Stellamove/Documents/README.md

# Documents
3D Part STL files and Documents related to Pitta
