Stellamove/Documents/3D Models/Spool/Spool_Cover.stl

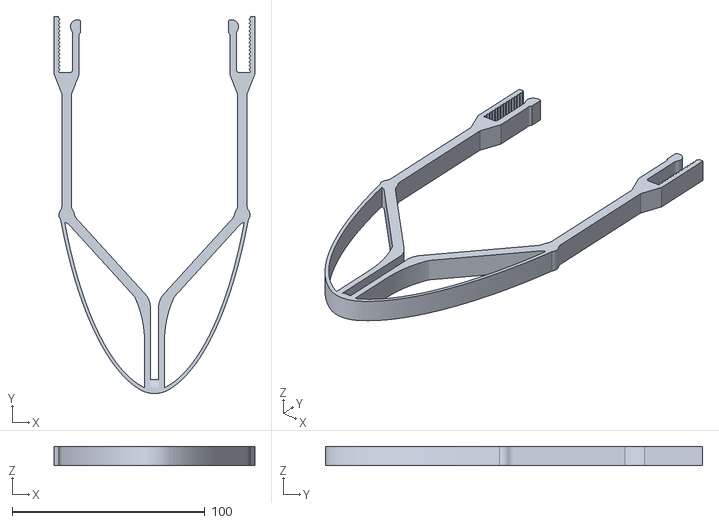
[picture p1: CAD file, 2022-07-28]
3D Models/Spool/Spool_Cover.stl
104.0 x 195.4 x 10.0
