Stellamove/Documents/3D Models/Spool/Spool_Bar_cover#2.stl

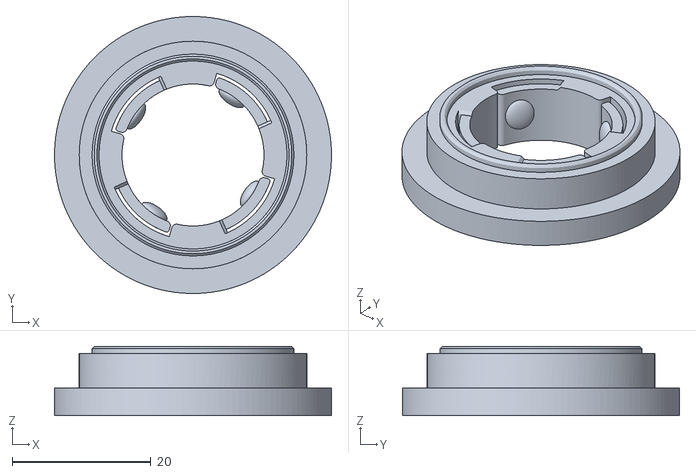
[picture p2: CAD file, 2022-07-28]
3D Models/Spool/Spool_Bar_cover#2.stl
40.0 x 40.0 x 10.0
