Stellamove/Documents/3D Models/Spool/Spool_Bar.stl

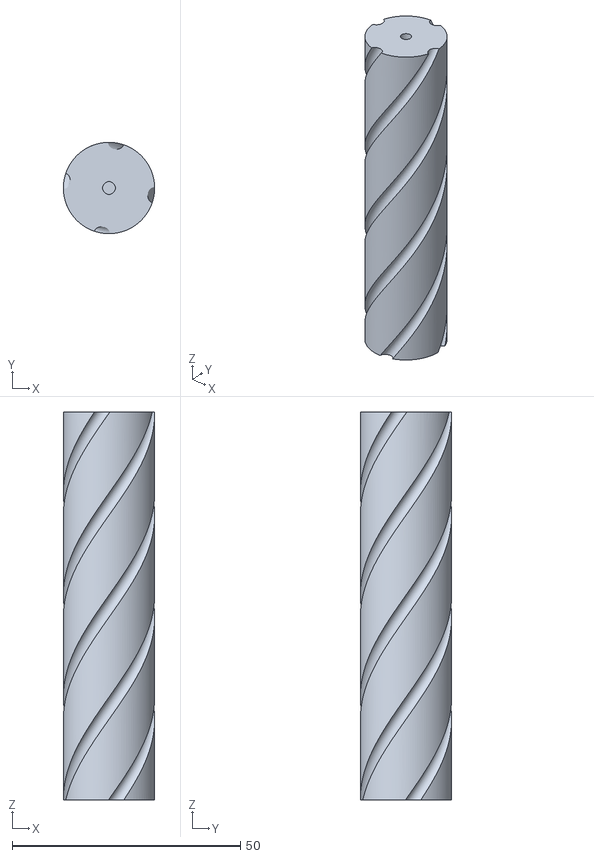
[picture p3: CAD file, 2022-07-28]
3D Models/Spool/Spool_Bar.stl
20.0 x 20.0 x 85.0
