Stellamove/Documents/3D Models/Spool/Spool_Tube Holder.stl

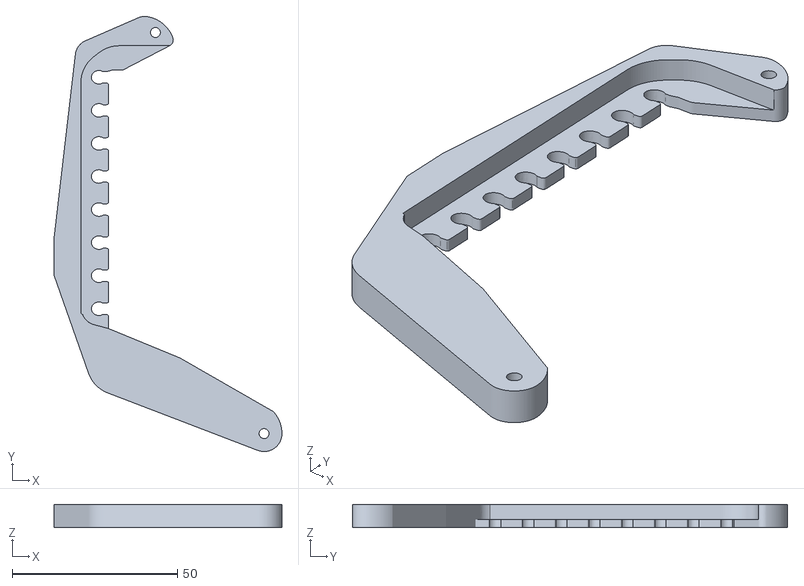
[picture p4: CAD file, 2022-07-28]
3D Models/Spool/Spool_Tube Holder.stl
68.9 x 131.6 x 7.00
