Stellamove/Documents/3D Models/Spool/Spool_Bar_cover#1.stl

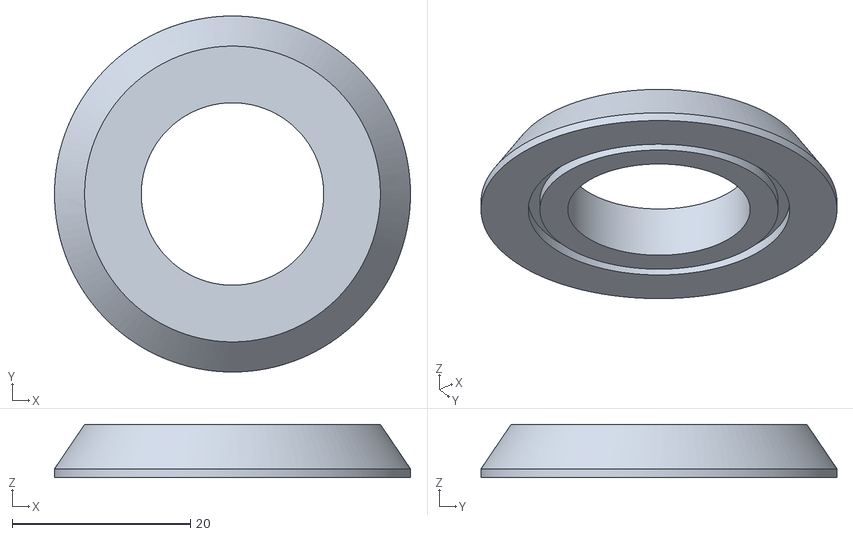
[picture p5: CAD file, 2022-07-28]
3D Models/Spool/Spool_Bar_cover#1.stl
40.0 x 40.0 x 6.00
