Stellamove/Documents/3D Models/Spool/Spool_Body.stl

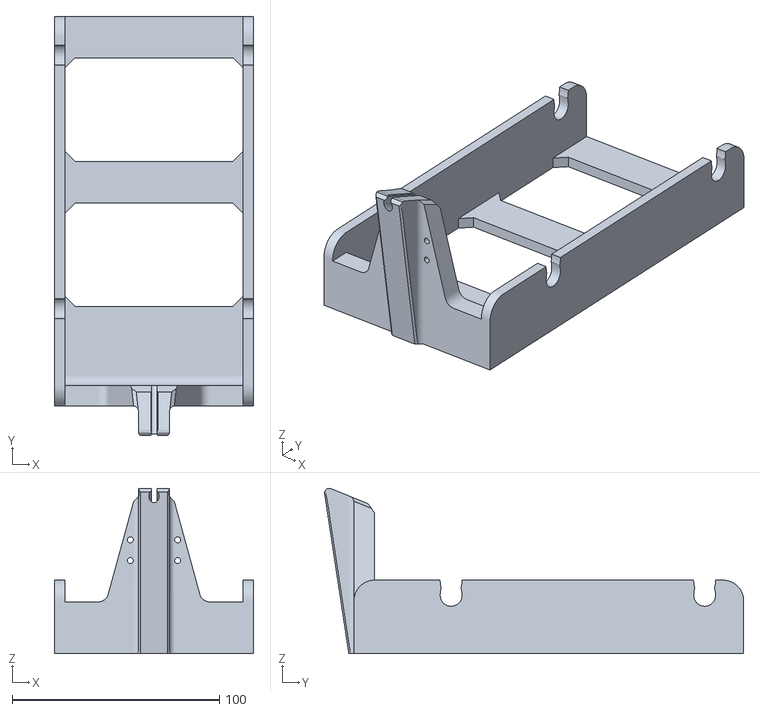
[picture p6: CAD file, 2022-07-08]
3D Models/Spool/Spool_Body.stl
96.0 x 202.3 x 79.8
