Stellamove/Documents/Manual/PITTA-User-Manual.pdf

# Multi-Color 3D Printing Module

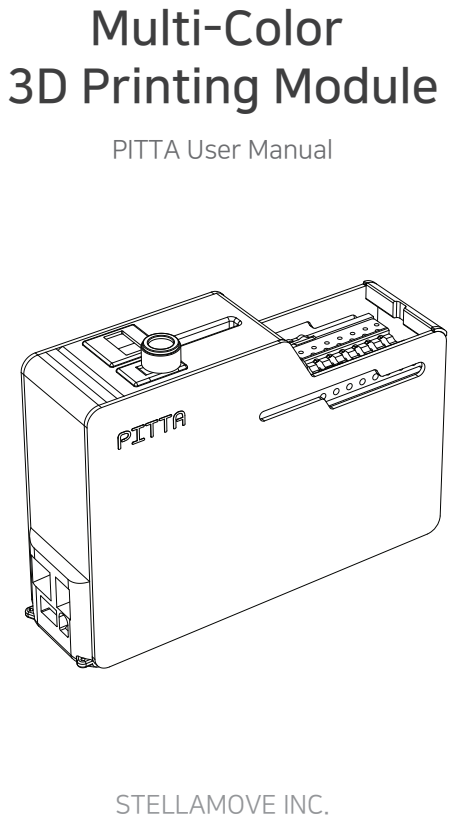
[picture p25: page 1]
STELLAMOVE INC.

PITTA User Manual

NOTES

UNPACKING

PARTS & FUNCTIONS

INSTALLATION & PREPARATION

02

03

04

06

HARD GRIP TUNING

Firmware Download for 3D Printer

PITTA MENU

Install EXTRUDER COMBINER

Install CYLINDER NOZZLE ASSEMBLY

Install PITTA BASE and BOWDEN TUBE

Install MOTOR EXTENSION CABLE

Install COMM EXTENSION CABLE

Friction Handling

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
# Contents

In the user manual, some functions may be changed without prior notice to the user to improve product performance. Please read [NOTES] before use.

8. TROUBLESHOOTING | 19
9. SPLITTER BOBBIN USAGE | 20

MENU & FUNCTIONS

TB_LEN : Length of detector to nozzle tube

BR_POS : Offset value of the Bearing Position

16

17

18

The PITTA is a precision machine and must be handled with care.

Check that the PITTA and 3D Printer are properly connected with various cables. (6~10page)

Turn on the power of the PITTA using the power switch. (Be sure to turn off the power when not in use)

Make sure all materials to be used are loaded in the proper location.

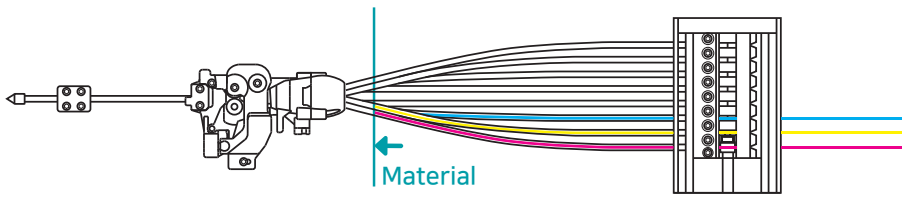
[picture p26: figure]
Material

Check that the drive gear of the PITTA and the Splitter Bobbin Usage is not loose.

Check that PITTA's drive gear is positioned to be in slot 1.

Before starting printing, use the PreHeat function to check whether the nozzle temperature is set to rise. 3D Printer will not start 3D Printing unless the nozzle temperature is at least 185 degrees.

Make sure the drive gear positions of the hard grip and PITTA are tuned for maximum extrusion pressure. (11~12,18page)

Recommendation : Material PLA, Nozzle Temp 205~215, Bed Temp 50 ~ 60°C

During PITTA working, ender3 UI blocked, so stop, pause etc will not work. It is because the ender's UI and its interaction with PITTA during PITTA operation interfere with the system operation.

Please use it on a flat floor out of direct sunlight.
If left unused for a long time, it may cause malfunction.
When storing, avoid direct sunlight and heat, and be careful not to accumulate dust. Do not disassemble the machine arbitrarily.

Always tidy up and clean after finishing work. (Foreign substances such as strings may cause clogging of the nozzle or machine failure)

The ideal ambient operating temperature is from 15 - 30 °C (60 - 86 °F).

# NOTES

# Quick Check Points Before start printing

# UNPACKING

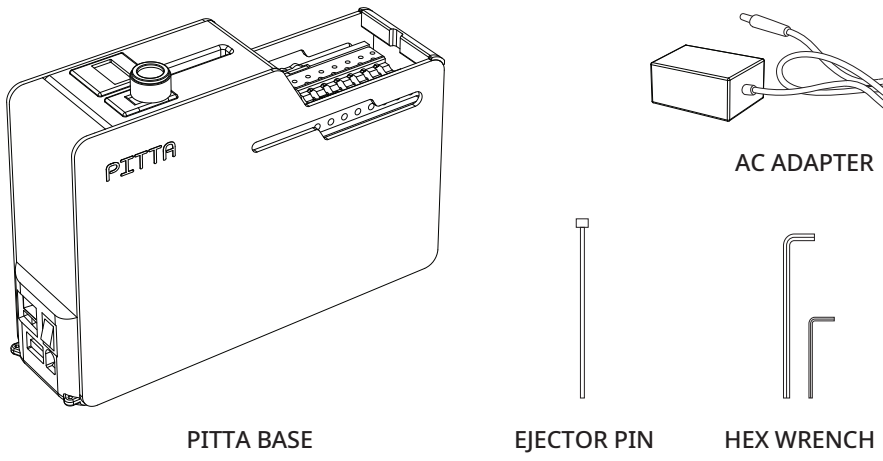
[picture p27: figure]
PITTA BASE; EJECTOR PIN; HEX WRENCH; AC ADAPTER

DETECTOR CABLE

MOTOR EXTENSION CABLE | COMM EXTENSION CABLE

PITTA LOGO STIKER

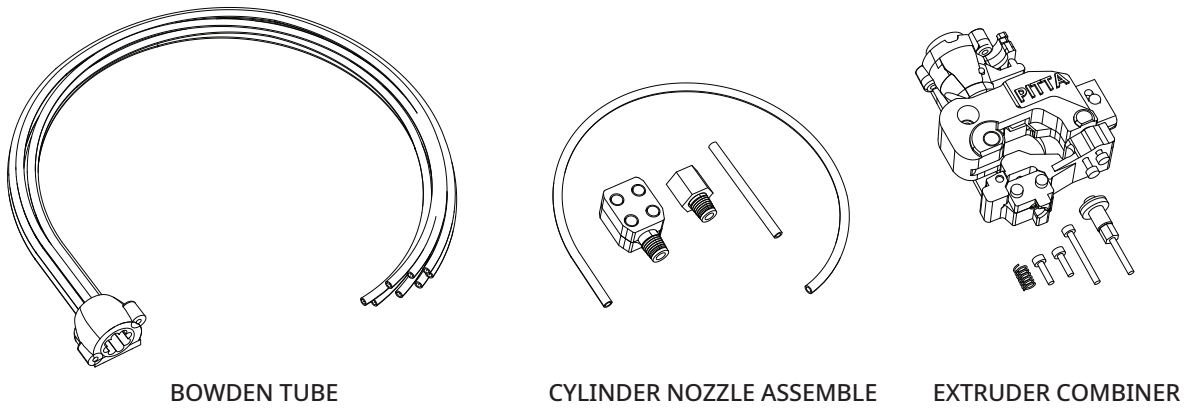
[picture p28: figure]
BOWDEN TUBE; CYLINDER NOZZLE ASSEMBLE; EXTRUDER COMBINER

The illustrations may differ slightly from the items shipped with your product.
PITTA is not responsible for any problems caused by using unauthorized accessories. Documentation and other materials necessary for installation and use can be obtained from the blog. (https://pitta-color-3dprinting.blogspot.com)

## PITTA BASE

ADAPTATION KIT (For Ender3 V2 or Pro 32bit)

# PARTS & FUNCTIONS

## PITTA BASE

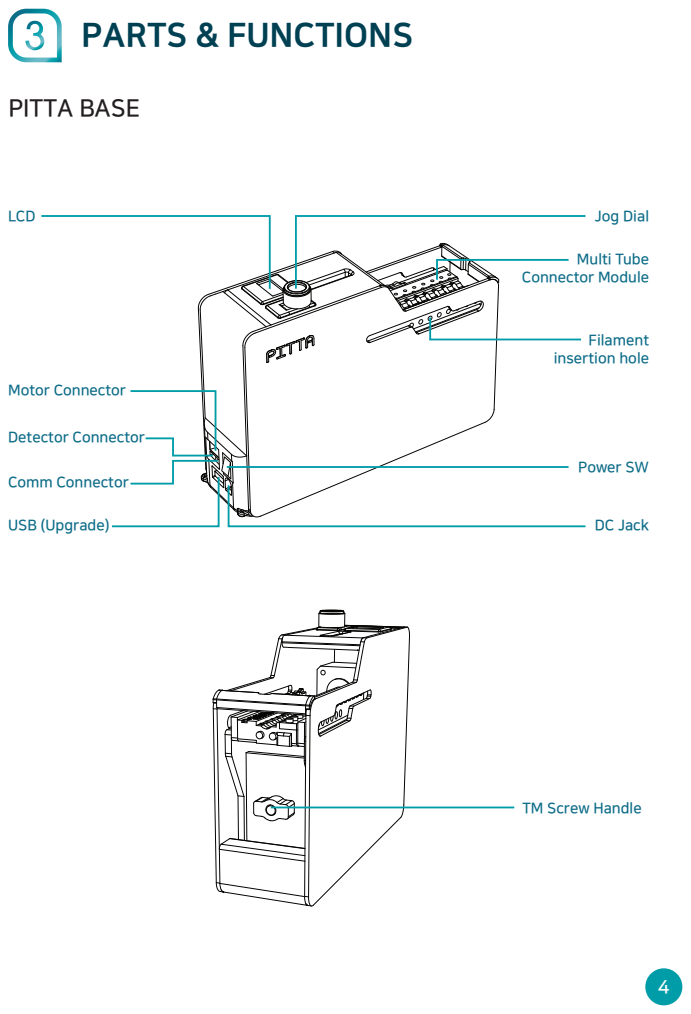
[picture p29: page 5]
LCD; Comm Connector; Detector Connector; Motor Connector; USB (Upgrade); Jog Dial; Multi Tube Connector Module; Filament insertion hole; DC Jack; Power SW

TM Screw Handle

## EXTRUDER COMBINER

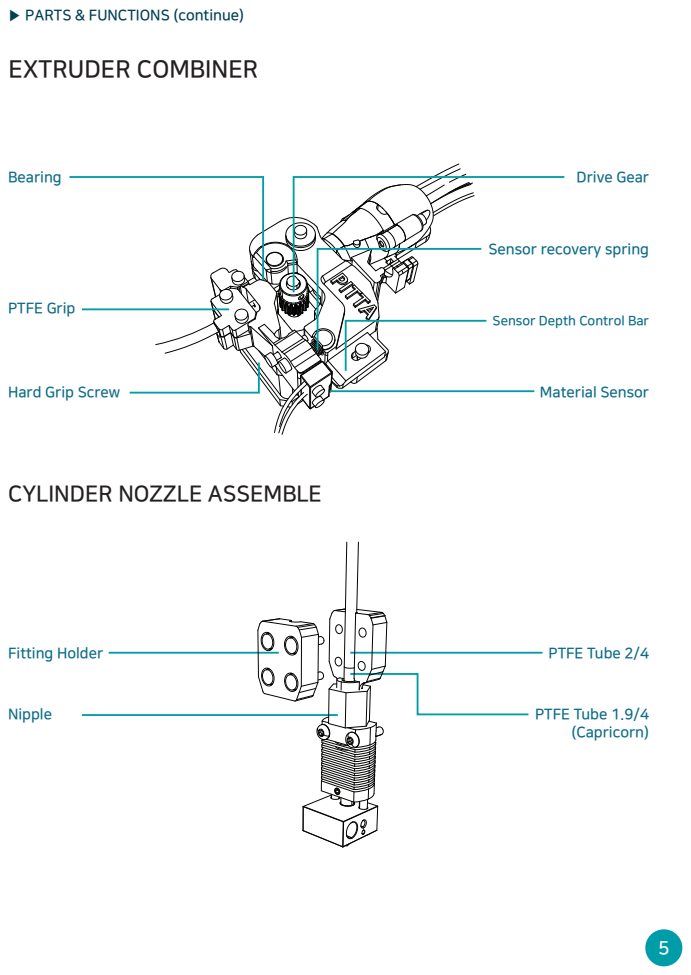
[picture p30: page 6]
Bearing; PTFE Grip; Drive Gear; Material Sensor; Fitting Holder; Nipple; PTFE Tube 2/4; PTFE Tube 1.9/4 (Capricorn)

▶ PARTS & FUNCTIONS (continue)

Sensor recovery spring

Sensor Depth Control Bar

Hard Grip Screw

CYLINDER NOZZLE ASSEMBLE

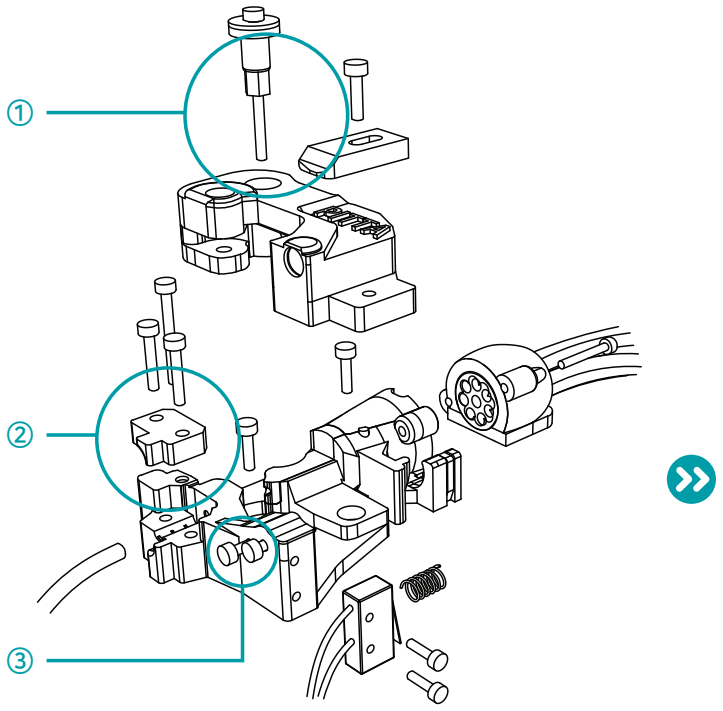
[picture p31: figure]

① Tighten the screw with a moderate force so that the lever moves smoothly.

② When tightening the screw, be careful as excessive tightening may cause the tube to be tightened, which may cause problems with the
movement of the material.

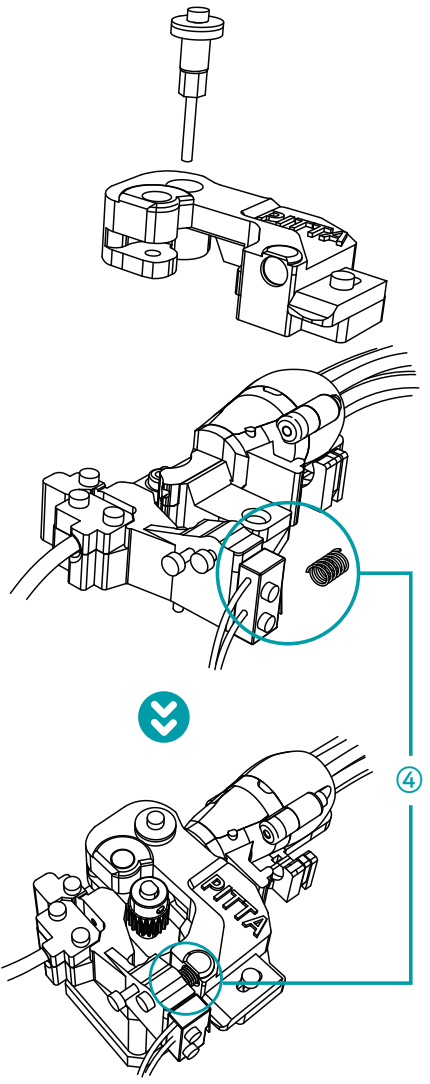
[picture p32: figure]

③ Leave them as they are when assembling with the screws used for tuning.

④ After the basic assembly is completed, the spring is well compressed and put in between.

# INSTALLATION & PREPARATION

## Install EXTRUDER COMBINER

Parts may be damaged if overtightened, so be aware of this and assemble as shown in the picture.

It is helpful to refer to the assembly video on the PITTA blog.

▶INSTALLATION & PREPARATION (continue)

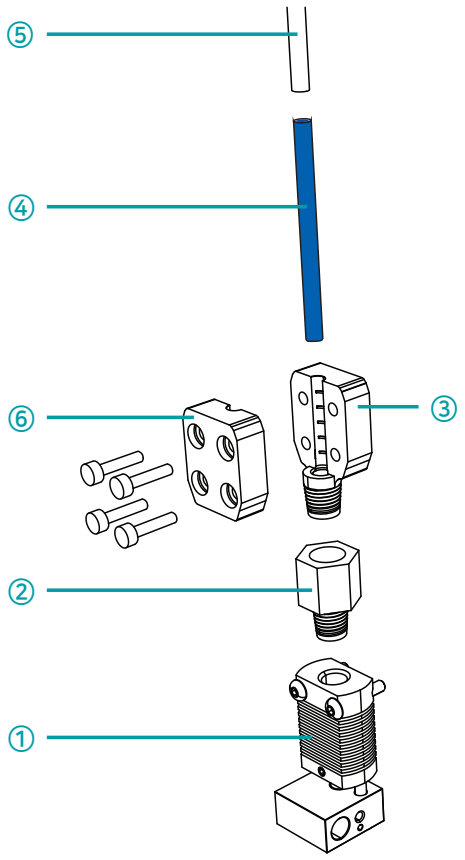
[picture p33: figure]
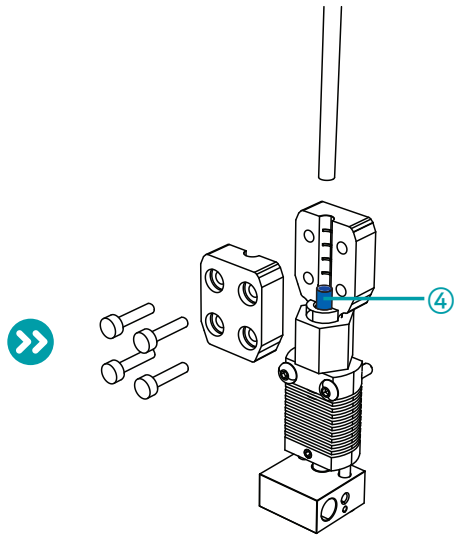
[picture p34: figure]

## After raising the temperature of the heater to 200 degrees or more, clean the inside of the ① cylinder so that there are no obstructions that may

interfere with assembly work.

Screw the ② nipple into the cylinder to fix it firmly.

STEP1

STEP2
STEP3 Turn the ③ grip to the nipple to fix it firmly.

## Push the ④ blue tube firmly into the cylinder until the bottom of the tube is in contact with the top of the nozzle. (Heater temperature is maintained over 200 degrees)

STEP4

## After properly locking the screw and putting the ⑥ grip cover on, insert the ⑤ Bowden tube in contact with the ④ blue tube, then tighten the screw

firmly so that there is no gap between the tubes.

STEP5

## Install CYLINDER NOZZLE ASSEMBLY

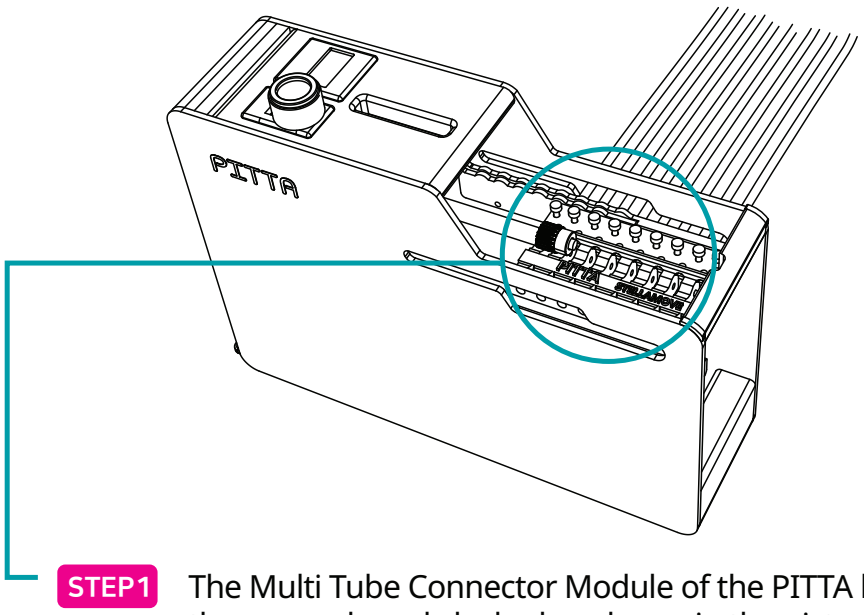
[picture p35: figure]
STEP1

## The Multi Tube Connector Module of the PITTA base is shipped with

the screws loosely locked as shown in the picture.

## Each screw has a different length, and if it is completely loosened, you

may not be able to lock it again, so please never loosen it all the way.

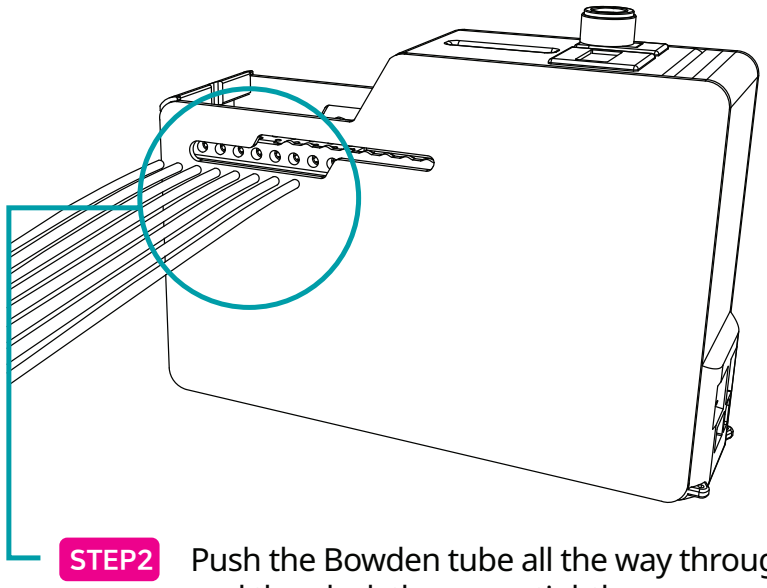
[picture p36: figure]
STEP2

Push the Bowden tube all the way through between the loose cover, and then lock the screw tightly.

▶INSTALLATION & PREPARATION (continue)

## Install PITTA BASE and BOWDEN TUBE

## Install MOTOR EXTENSION CABLE

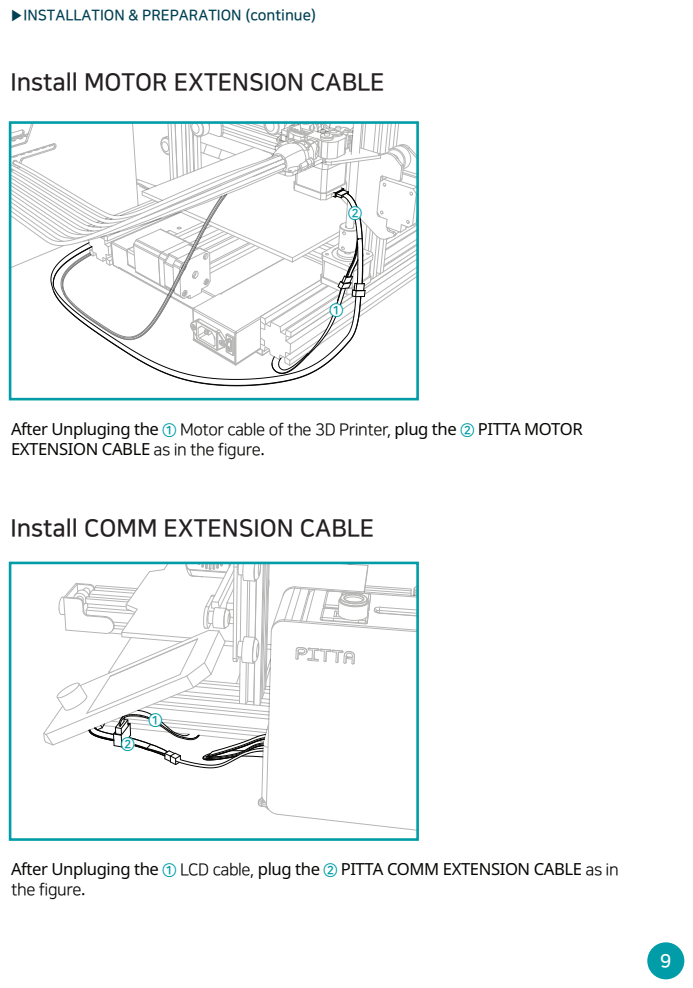
[picture p37: page 10]

▶INSTALLATION & PREPARATION (continue)

After Unpluging the ① Motor cable of the 3D Printer, plug the ② PITTA MOTOR
EXTENSION CABLE as in the figure.

Install COMM EXTENSION CABLE

After Unpluging the ① LCD cable, plug the ② PITTA COMM EXTENSION CABLE as in
the figure.

## Friction Handling

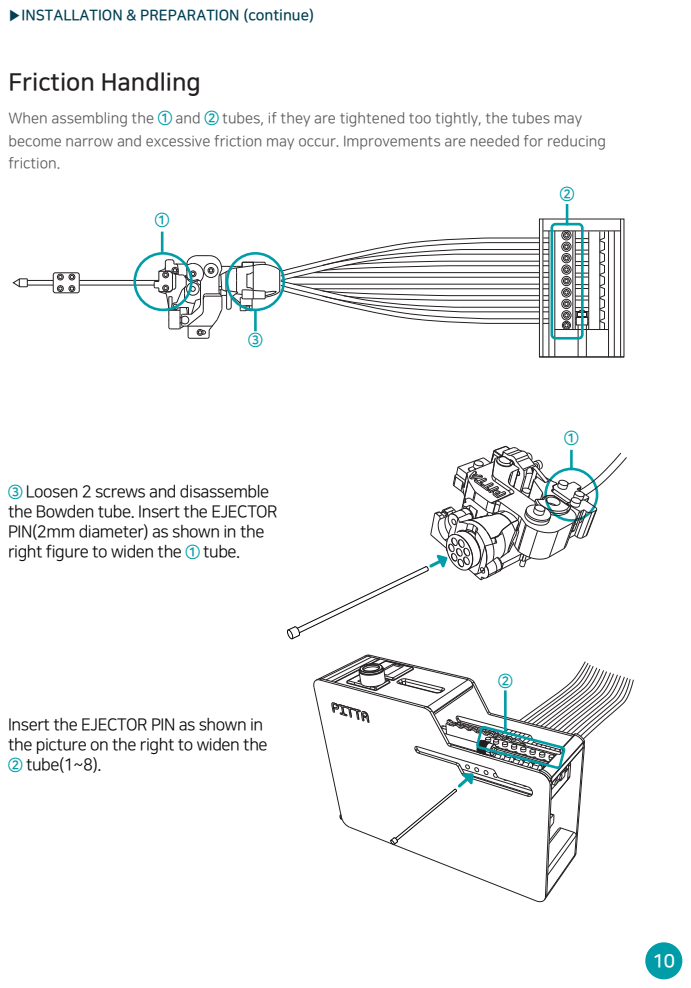
[picture p38: page 11]

▶INSTALLATION & PREPARATION (continue)

When assembling the ① and ② tubes, if they are tightened too tightly, the tubes may
become narrow and excessive friction may occur. Improvements are needed for reducing
friction.

③ Loosen 2 screws and disassemble
the Bowden tube. Insert the EJECTOR
PIN(2mm diameter) as shown in the
right figure to widen the ① tube.

Insert the EJECTOR PIN as shown in
the picture on the right to widen the
② tube(1~8).

## STEP1 condition: without filament

# HARD GRIP TUNING

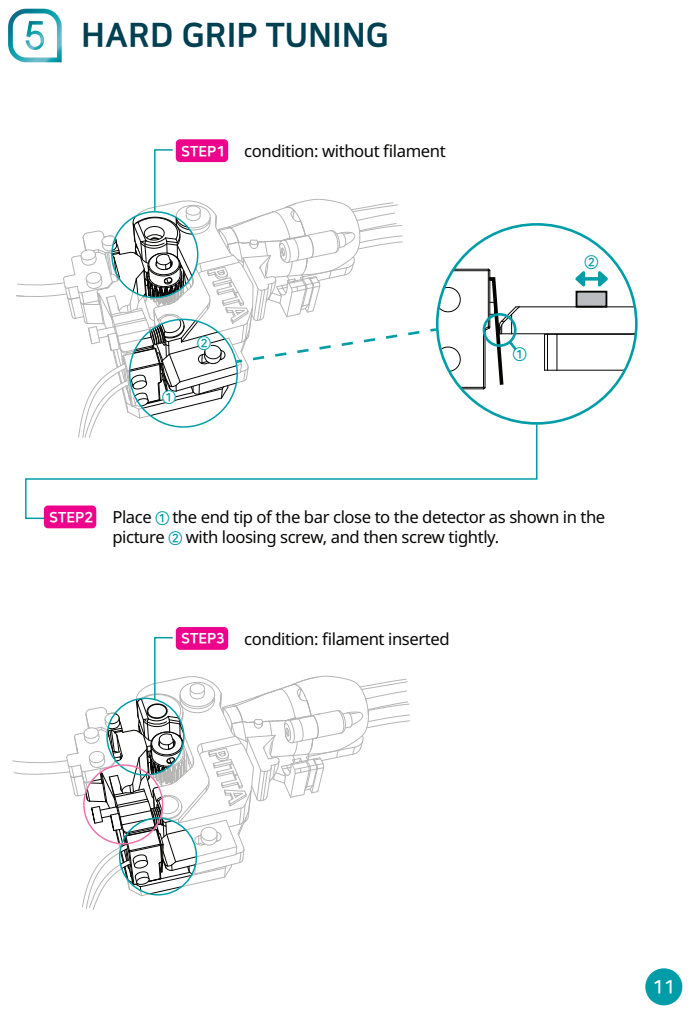
[picture p39: page 12]
STEP2

Place ① the end tip of the bar close to the detector as shown in the
picture ② with loosing screw, and then screw tightly.

STEP3 condition: filament inserted

# Tune

# Result

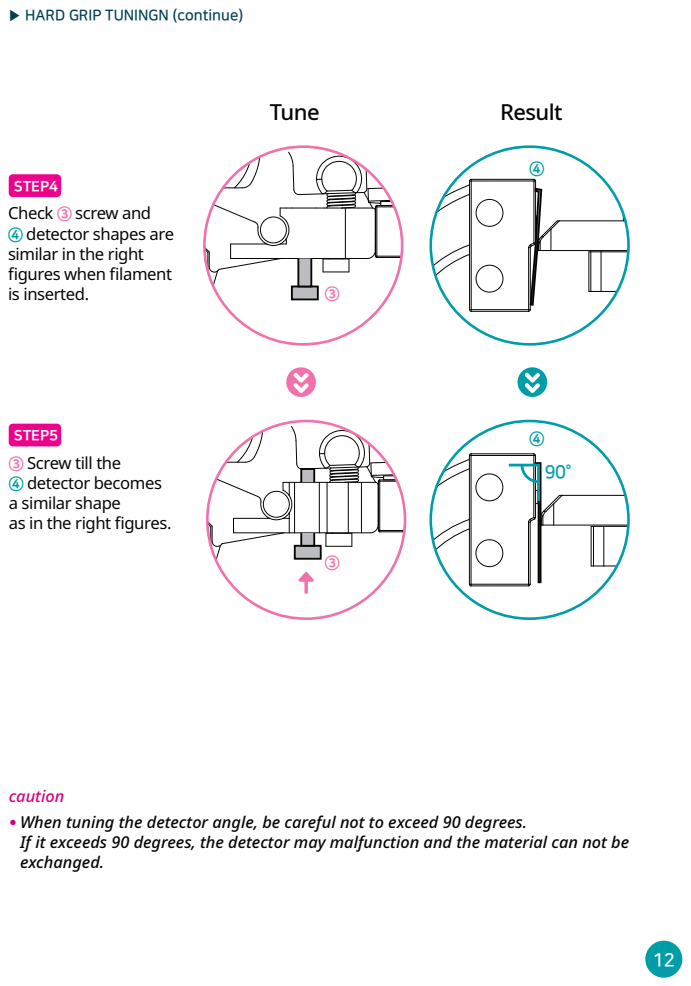
[picture p40: page 13]

▶ HARD GRIP TUNINGN (continue)

STEP4
Check ③ screw and
④ detector shapes are
similar in the right
figures when filament
is inserted.

STEP5
③ Screw till the
④ detector becomes
a similar shape
as in the right figures.

caution
When tuning the detector angle, be careful not to exceed 90 degrees.
If it exceeds 90 degrees, the detector may malfunction and the material can not be
exchanged.

# Firmware Download for 3D Printer

## Firmware Update

Ender3 V2 requires the mainboard update and LCD update. Ender3 Pro requires the mainboard update only.

https://github.com/Stellamove/Marlin4Pitta/releases →Check the 3D Printer model and motherboard version before.

### Download Link

### Firmware

The firmware file differs depending on the 3D printer model and motherboard. Download the appropriate file that matches your 3D printer.

- DWIN_SET.zip (LCD for Ender3 V2)
- firmware-XXXXXXXX-ender3pro-4.2.2.bin
- firmware-XXXXXXXX-ender3pro-4.2.7.bin
- firmware-XXXXXXXX-ender3v2-4.2.2.bin
- firmware-XXXXXXXX-ender3v2-4.2.7.bin

Download the mainboard firmware file from download link and copy it to the empty SD card.

Firmware update starts automatically when the power is turned on, and the update ends when booting is complete.

Insert the SD card into the 3D Printer and reboot(power off and on)

1.

2.
3.

### Ender3 V2

### │Main Board Firmware Update│

Download the LCD firmware file(DWIN_SET.zip) from download link, unzip it, and copy the whole including the folder to the empty SD card.
Folder name should be “DWIN_SET”.

After inserting the SD card into the slot on the back of the LCD, reconnect the LCD cable and turn on the 3D Printer.

Turn off the 3D Printer, disconnect the LCD cable, and disassemble the LCD with a hexagon wrench.

1.

2.

3.

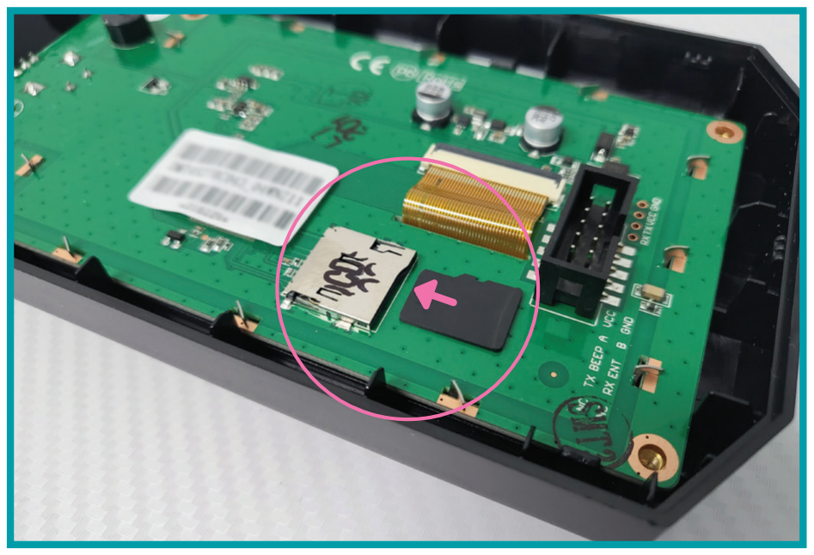
[picture p41: figure]

4. When the LCD screen turns from blue to orange, turn off the 3D Printer again.
5. Remove the inserted 3D card and reassemble the LCD.

### │LCD module Firmware Update│

▶Firmware Download for 3D Printer (continue)

If the boot screen does not appear after updating, format the SD card and update again. (FAT32, 4096 format)

▶Firmware Download for 3D Printer (continue)

When the 3D Printer is turned on and the screen is displayed as the following picture, the update is complete.

6.

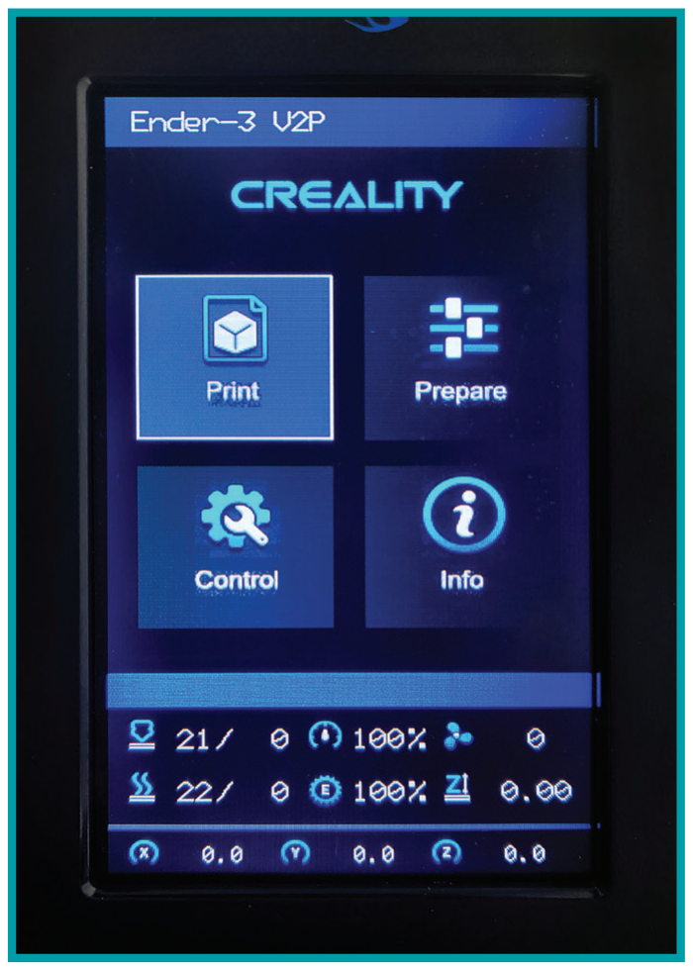
[picture p42: figure]

Download the mainboard firmware file from download link and copy it to the empty SD card.

Firmware update starts automatically when the power is turned on, and the update ends when booting is complete.

Insert the SD card into the 3D Printer and reboot(power off and on)

1.

2.
3.

### Ender3 Pro

### │Main Board Firmware Update│

If the boot screen does not appear after updating, format the SD card and update again. (FAT32, 4096 format)

If the boot screen does not appear after updating, format the SD card and update again. (FAT32, 4096 format)

## Jog Dial

## MENU & FUNCTIONS

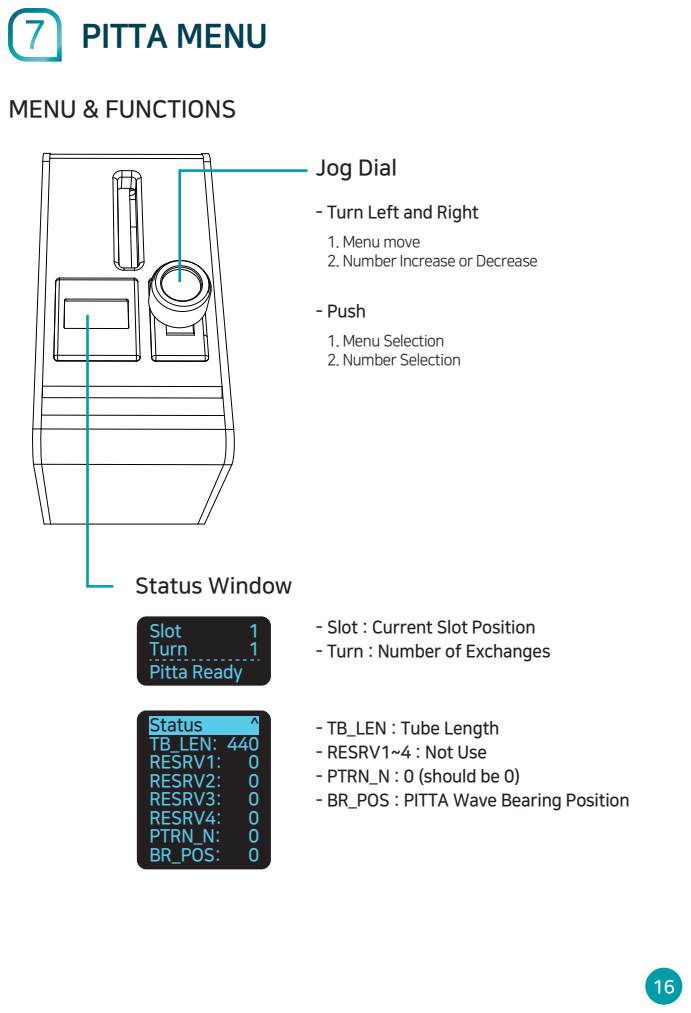
[picture p43: page 17]
Status Window; 1. Menu Selection 2. Number Selection; - Push; Slot Turn Pitta Ready; Status TB_LEN: RESRV1: RESRV2: RESRV3: RESRV4: PTRN_N: BR_POS:; PITTA MENU

- Turn Left and Right
1. Menu move
2. Number Increase or Decrease

- Slot : Current Slot Position
- Turn : Number of Exchanges

- TB_LEN : Tube Length
- RESRV1~4 : Not Use
- PTRN_N : 0 (should be 0)
- BR_POS : PITTA Wave Bearing Position

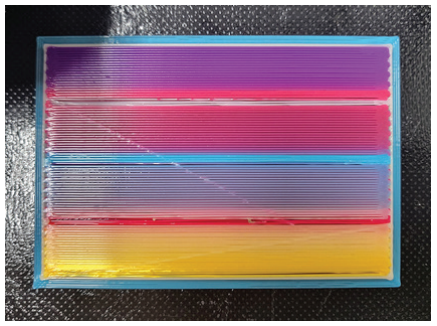
[picture p44: figure]

440 TB_LEN is the Factory default value.

## Adjust the tube length to set it appropriately as shown in the image. The unit of tube length 1 is approximately 1 mm of 1.75

filaments.

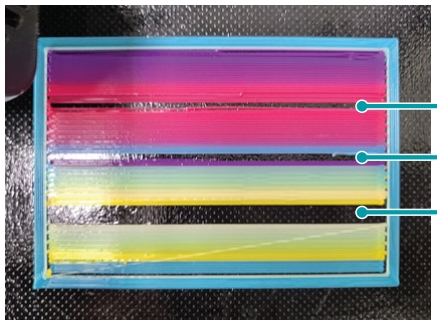
[picture p45: figure]

If you see empty space as in the picture, it means that the TB_LEN value is small.

## Increase this value. ex) 440 → 445

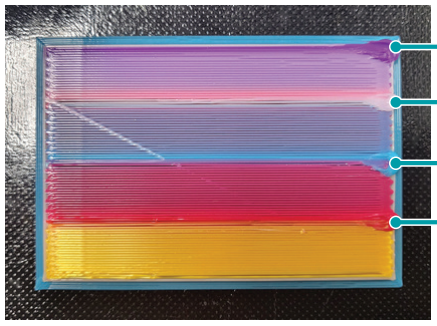
[picture p46: figure]

If the tube length is set to be over,
the filaments will be stacked in dots. Please lower the number for tube length. ex) 440 → 435

### Status TB_LEN: RESRV1: RESRV2:

^
440
0
0

When you tune the TB_LEN at first, it is better to set its value 20 lower (420), then increase its value by +5 every time because stacked dots might induce nozzle hitting and layer shifting.
Also, there are many factors that might affect TB_LEN, it is better to maintain its value lower than its fittest value for having margin.

## TB_LEN : Length of detector to nozzle tube

▶PITTA MENU (continue)

### Status TB_LEN: RESRV1: RESRV2: RESRV3: RESRV4: PTRN_N: BR_POS:

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
BR_POS: 10

BR_POS: -10

## BR_POS : Offset value of the Bearing Position

▶PITTA MENU (continue)

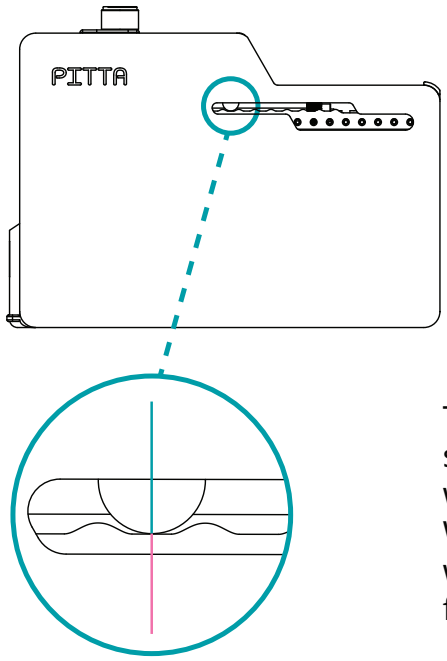
[picture p47: figure]

## The offset value of the BR_POS should be corrected so that the center of the bearing in the figure aligns

with the center of the wave-shaped guide.

## When the center of the bearing and the center of the wave-shaped guide are aligned, the material can be

fed with the maximum pressure of the drive gear.

## When the drive gear moves for material selection if it does not match the center as shown in the left

figure, increase the value of BR_POS appropriately.

## (ex: 10 means shift right the bearing approximately

1mm | )

## When the drive gear moves for material selection if it does not match the center as shown in the left

figure, lower the value of BR_POS appropriately.

## (ex: 10 means shift left the bearing approximately

1mm | )

After changing the value, when the drive gear returns to slot 1, the changed value is applied and must be saved. (The unsaved value will return to the previous setting value when the power is turned off)

1.
2.

1.

2.
3.

In case the extruder temperature is 140°C and Bed temperature 40°C.

The filament may have thickened or a string may be caught in the extruder.

## Check1

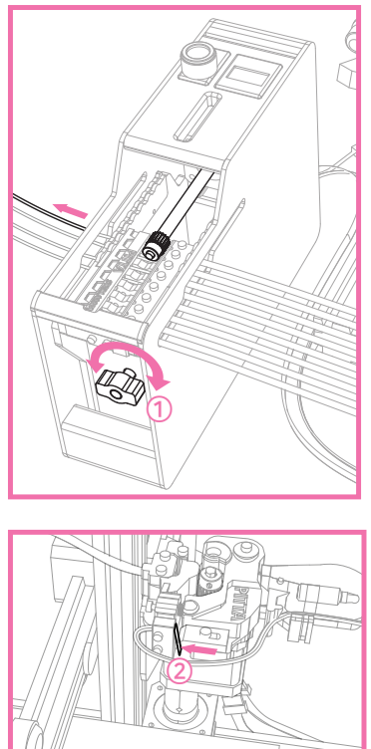
[picture p48: figure]

Turn the ① TM Screw Handle slightly and take out the filament.

Cut the abnormal parts of the filament.
3. Insert the filament and turn the ① TM Screw Handle back into place.
4. Push the ② Material Sensor for a while(~1sec), printing starts when after the Nozzle temperature reaches around 185°C.

## - Solution

## When printing is abnormal paused

### Reason

In case the extruder temperature is printing temperature.

And the filament is in the main bowden tube?

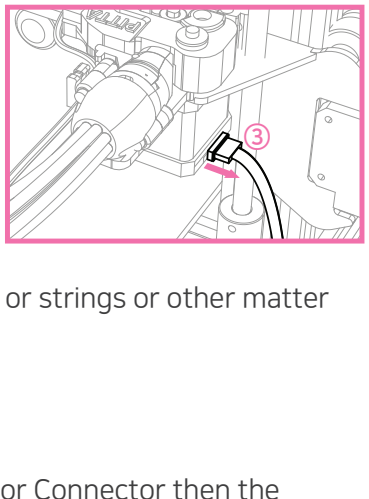
[picture p49: figure]

It is the case that the material could not be removed due to friction or strings or other matter during the material exchange.

## Check2

Turn the ① TM Screw Handle slightly and disconnect the ③ Motor Connector then the extruder gear becomes loose. Then remove the filament.

Plug the ③ Motor Connector back and rotate the ① TM Screw Handle back into place.

Push the ② Material Sensor for a while(~1sec), printing starts when after the Nozzle temperature reaches around 185°C.

## - Solution

### Reason

# TROUBLESHOOTING

▶TROUBLESHOOTING (continue)

smooth flow of material

## Normal connection

Material flow is impeded by the gap. Causes of nozzle clogging

## Gap between nozzle and tube

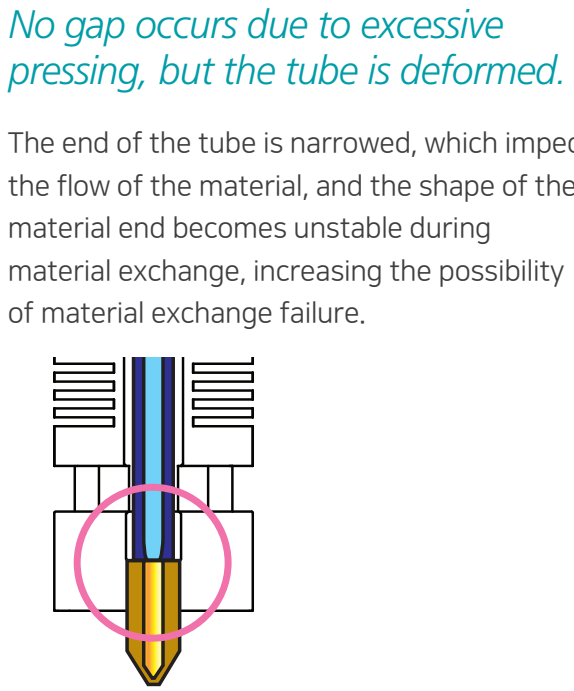
[picture p50: figure]
material end becomes unstable during material exchange, increasing the possibility of material exchange failure.; No gap occurs due to excessive pressing, but the tube is deformed.

The end of the tube is narrowed, which impedes the flow of the material, and the shape of the

Reassemble so that nozzle and tube are in contact

## - Solution

Reassemble the narrowed tube by widening it using EJECTPR PIN or replacing it with
a new tube

## - Solution

## Tube connection troubleshooting when string happens or

material exchange jam happens.

# SPLITTER BOBBIN USAGE

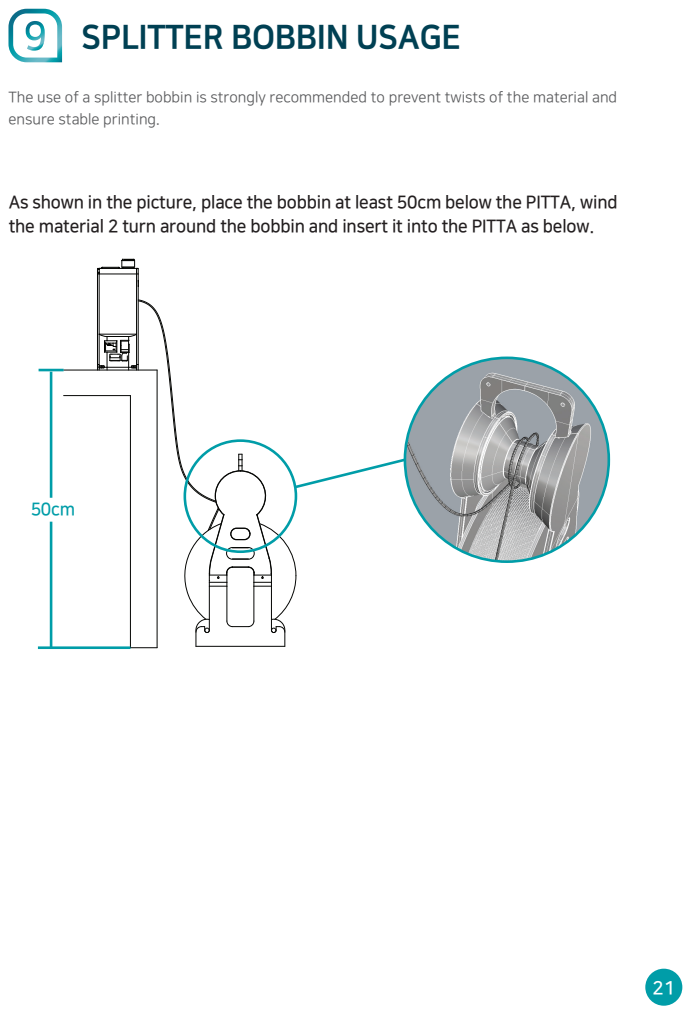
[picture p51: page 22]

The use of a splitter bobbin is strongly recommended to prevent twists of the material and
ensure stable printing.

As shown in the picture, place the bobbin at least 50cm below the PITTA, wind
the material 2 turn around the bobbin and insert it into the PITTA as below.

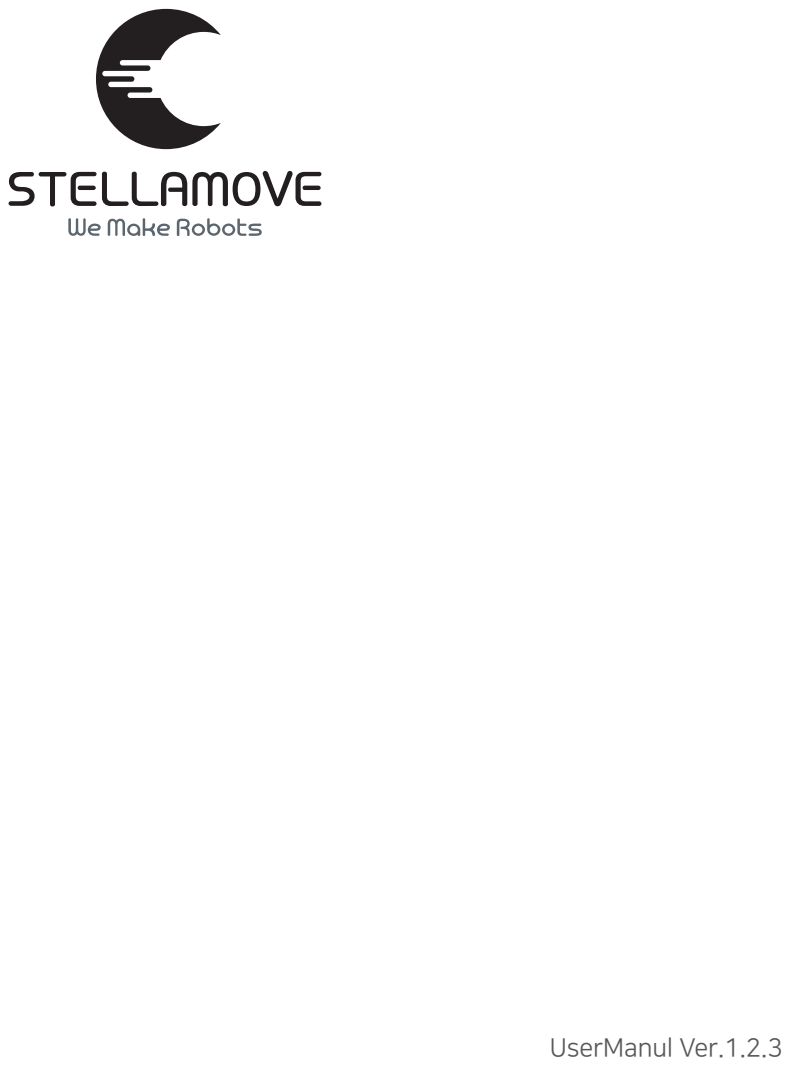
[picture p52: page 23]
UserManul Ver.1.2.3
